xx0x/badger/pcb/badger_v2/jlcpcb/production_files/BOM-badger_v2.csv

Comment | Designator | Footprint | LCSC | Quantity
0 | R19,R20 | R_0603_1608Metric | C21189 | 2
10 (250mW) | R34,R35 | R_0805_2012Metric | C317221 | 2
100k | R22,R36,R49,R9 | R_0603_1608Metric | C25803 | 4
100n | C10,C2,C23,C3,C5,C6,C7,C8,C9 | C_0603_1608Metric | C14663 | 9
10k | R3,R32,R8 | R_0603_1608Metric | C25804 | 3
10p | C21,C22 | C_0603_1608Metric | C1634 | 2
10u | C1,C11,C24,C4 | C_0603_1608Metric | C19702 | 4
1206-PTSMD026 | Q1,Q2,Q3 | Phototransistor | C242255 | 3
150k | R46 | R_0603_1608Metric | C22807 | 1
1N4148W | D4 | D_SOD-123 | C81598 | 1
1k | R10,R14,R17,R18,R37,R40,R43 | R_0603_1608Metric | C21190 | 7
1u | C12,C13,C14,C15,C16,C17,C18,C19,C20 | C_0603_1608Metric | C15849 | 9
20k | R15,R23,R24,R25,R26,R27,R28,R31,R33 | R_0603_1608Metric | C4184 | 9
220 | R38,R4,R41,R44,R5 | R_0603_1608Metric | C22962 | 5
24C02S(XBLW) | U4 | SOT-23-5 | C18723540 | 1
2k2 | R29,R30 | R_0603_1608Metric | C4190 | 2
33 (250mW) | R6,R7 | R_0805_2012Metric | C17634 | 2
33k | R16 | R_0603_1608Metric | C4216 | 1
470 | R39,R42,R45 | R_0603_1608Metric | C23179 | 3
500 mA | F1 | Fuse_0805_2012Metric | C2977522 | 1
5V1 | D5 | D_SOD-123 | C19077401 | 1
5k1 | R1,R11,R12,R13,R2,R47,R48 | R_0603_1608Metric | C23186 | 7
74AHCT1G14 | U6 | SOT-23-5 | C55144666 | 1
AO3401A | Q5 | SOT-23 | C15127 | 1
B5819W | D6 | D_SOD-123 | C8598 | 1
GZ2012D601TF | FB1 | L_0805_2012Metric | C1017 | 1
LPA4722AQVF | U3 | WQFN-16-1EP_3x3mm_P0.5mm_EP1.6x1.6mm_ThermalVias | C517163 | 1
ME6211C33M5 | U5 | SOT-23-5 | C82942 | 1
MHP5050DRGBCT | D1,D2,D3 | LED_RGB_5050-6 | C7470880 | 3
MMBT3904 | Q4 | SOT-23 | C20526 | 1
MST-22D18G3-BD | SW4 | MST-22D18G3-BD | C7507441 | 1
PJ-313D | J2,J3,J4 | Jack_3.5mm_PJ-313D | C668608 | 3
PY32F071C1BU6TR | U7 | QFN-48-1EP_6x6mm_P0.4mm_EP4.3x4.3mm | C7434410 | 1
TLP185 | U2 | SOIC-4_4.55x3.7mm_P2.54mm | C388375 | 1
USBLC6-2SC6 | U1 | SOT-23-6 | C2687116 | 1
USB_C_Receptacle_USB2.0_16P | J1 | TYPE-C-31-M-12 | C2765186 | 1
X322524MOB4SI | Y1 | Crystal_SMD_3225-4Pin_3.2x2.5mm | C70590 | 1
