xx0x/badger/3d_models/badger-bottom-plate.step

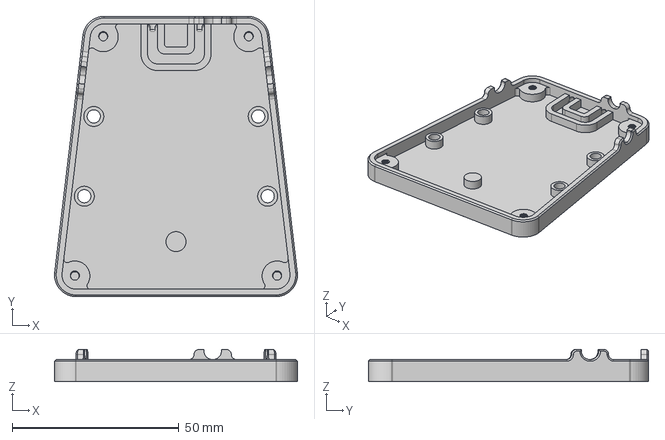
[picture p3: CAD file, 2026-10-28]
3d_models/badger-bottom-plate.step
72.8 x 84.0 x 9.60 mm
