xx0x/badger/pcb/badger_v2/3d_models/TLP185E.STEP

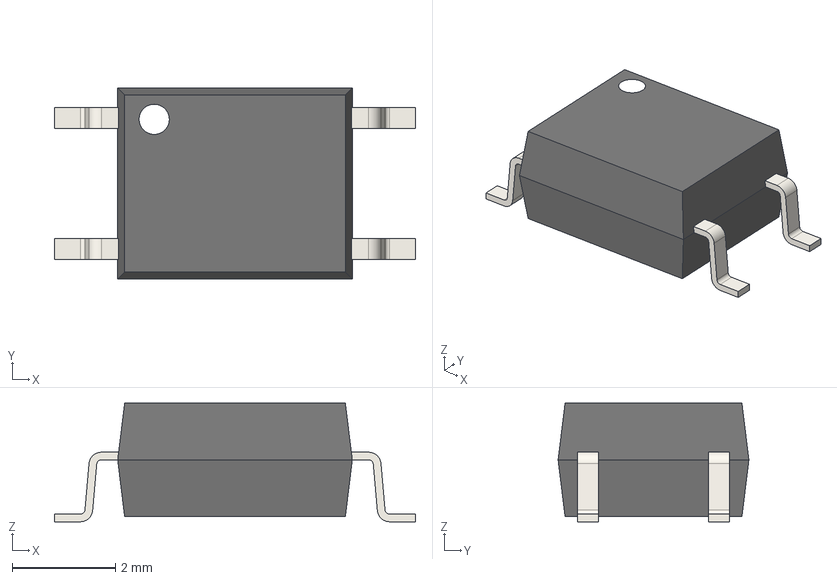
[picture p4: CAD file, 2026-10-28]
pcb/badger_v2/3d_models/TLP185E.STEP
7.00 x 3.70 x 2.30 mm
