xx0x/badger/pcb/badger_v2/3d_models/RV09ACF-40-20K-B10K.step

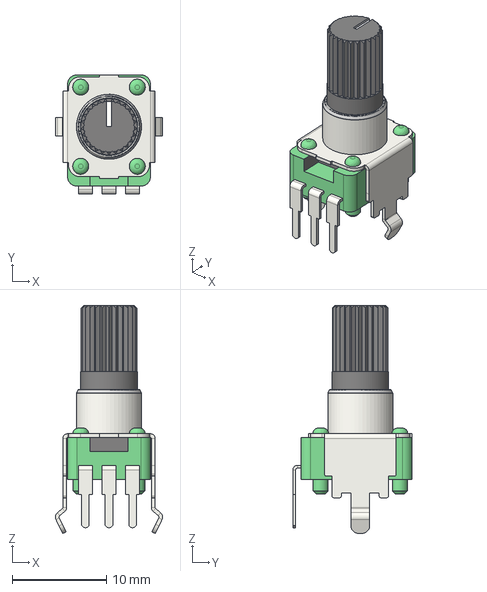
[picture p5: CAD file, 2026-10-28]
pcb/badger_v2/3d_models/RV09ACF-40-20K-B10K.step
11.4 x 12.7 x 24.2 mm
