xx0x/badger/pcb/badger_v2/3d_models/MST22D18G2.step

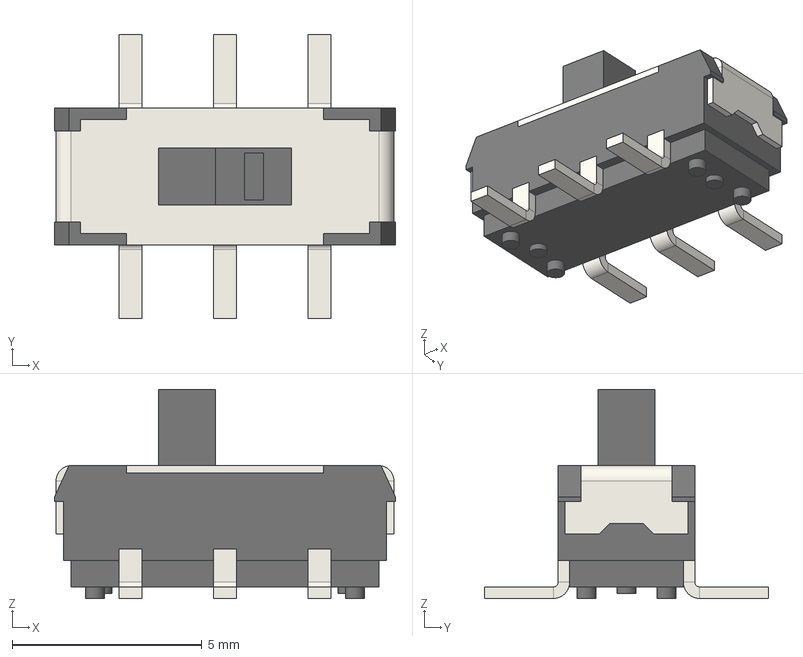
[picture p6: CAD file, 2026-10-28]
pcb/badger_v2/3d_models/MST22D18G2.step
8.99 x 7.49 x 5.51 mm
