xx0x/badger/pcb/badger_v2/3d_models/PJ313D.STEP

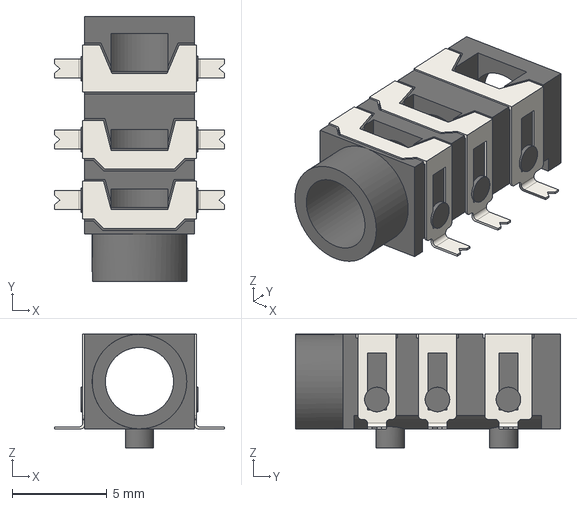
[picture p7: CAD file, 2026-10-28]
pcb/badger_v2/3d_models/PJ313D.STEP
9.00 x 14.0 x 6.00 mm
