xx0x/badger/pcb/badger_v2/3d_models/MHP5050DRGBCT.step

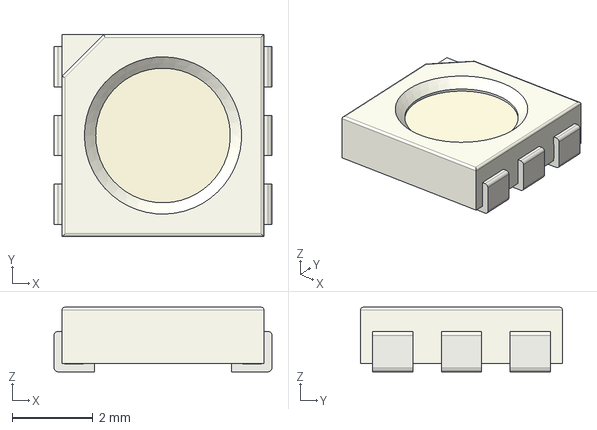
[picture p8: CAD file, 2026-10-28]
pcb/badger_v2/3d_models/MHP5050DRGBCT.step
5.40 x 5.00 x 1.60 mm
