xx0x/badger/pcb/badger_v2/3d_models/B3F_4000.step

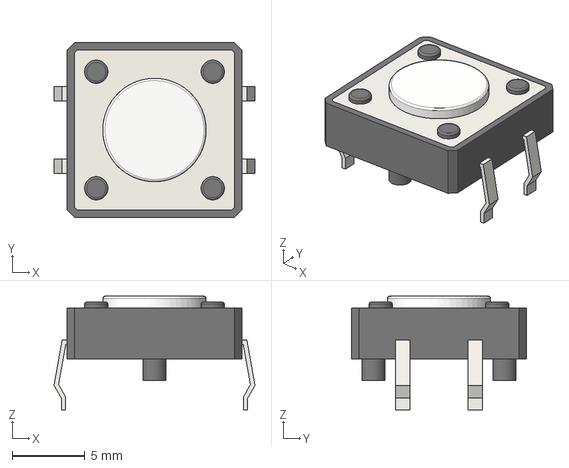
[picture p9: CAD file, 2026-10-28]
pcb/badger_v2/3d_models/B3F_4000.step
13.8 x 12.0 x 7.80 mm
