xx0x/badger/(list of files, cad)

Other CAD files:
3d_models/badger-bottom-plate.stl
3d_models/blender/badger.blend
