xx0x/badger/pcb/badger_v2/badger_v2.pdf

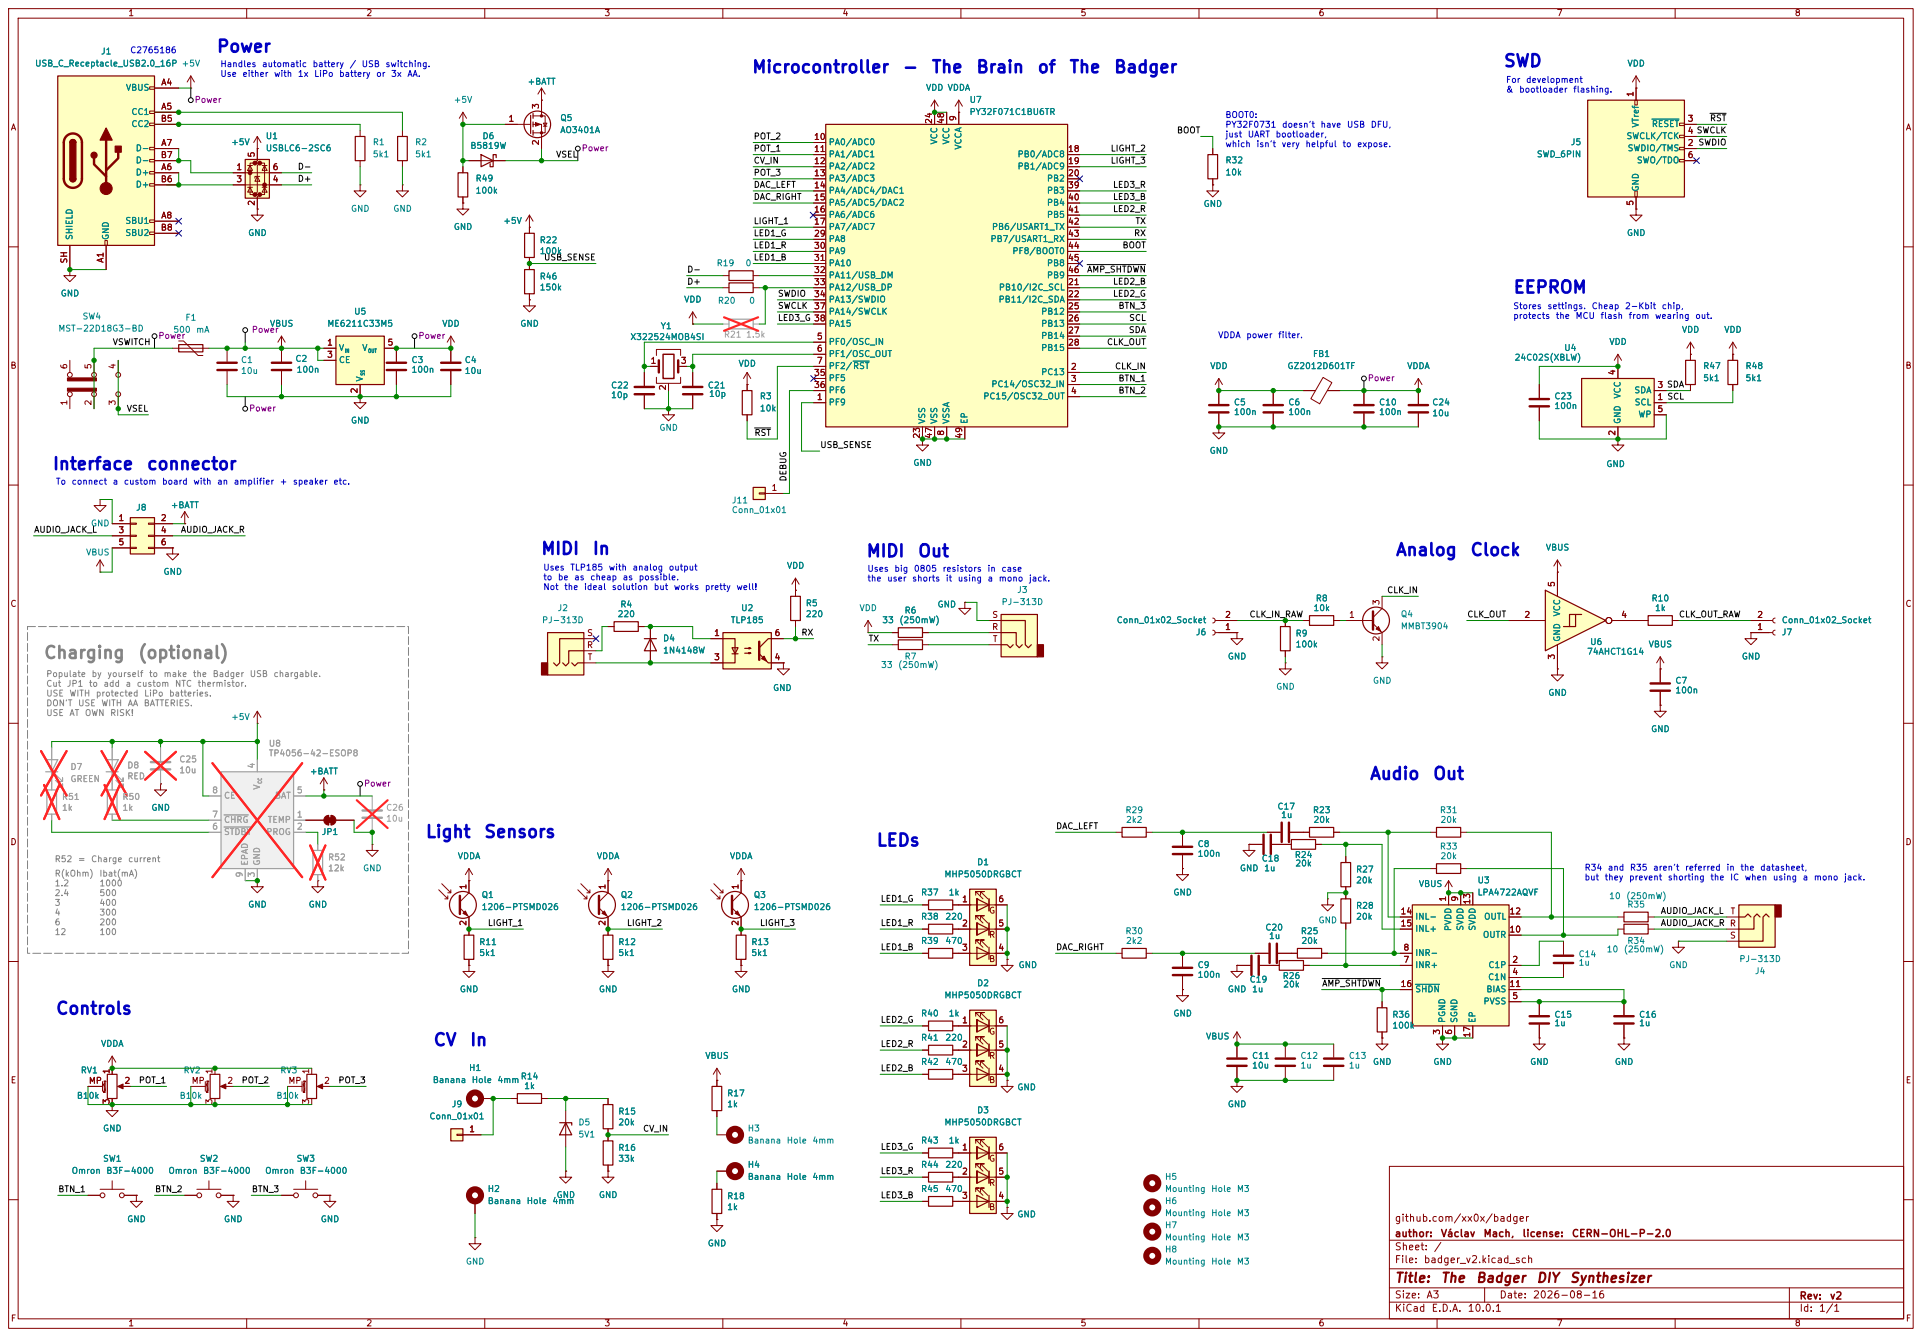
[picture p25: page 1]

R34 and R35 aren't referred in the datasheet, but they prevent shorting the IC when using a mono jack. Microcontroller - The Brain of The Badger

For development & bootloader flashing. BOOT0: PY32F0731 doesn't have USB DFU,

Stores settings. Cheap 2-Kbit chip, protects the MCU flash from wearing out. Uses TLP185 with analog output

to be as cheap as possible. Not the ideal solution but works pretty well!

Uses big 0805 resistors in case
the user shorts it using a mono jack. LEDs

9 OUTR 10 BIAS 11 OUTL 12 SVDD 13

github.com/xx0x/badger
author: Václav Mach, license: CERN-OHL-P-2.0
Id: 1/1 Title: The Badger DIY Synthesizer File: badger_v2.kicad_sch Sheet: /
