xx0x/badger/manuals/badger-quick-guide-en.pdf

# The Badger

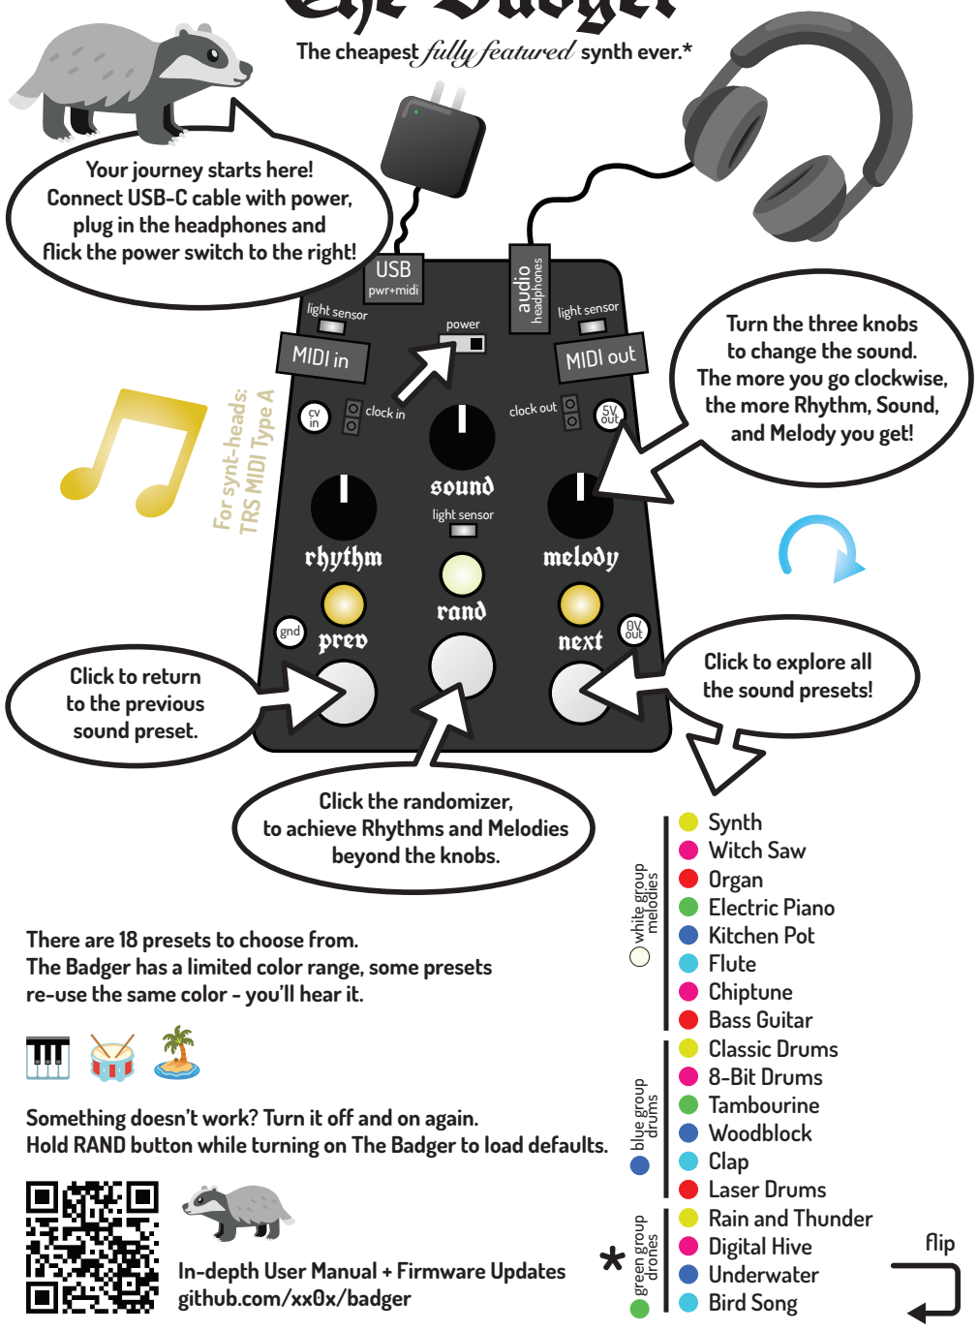
[picture p26: figure]
rhythm; sound; melody; rand; prev; next; MIDI in; MIDI out; audio; USB pwr+midi; headphones; clock in; clock out; gnd; 5Vout; power; 0Vout; light sensor; Turn the three knobs to change the sound. The more you go clockwise, the more Rhythm, Sound, and Melody you get!; Your journey starts here! Connect USB-C cable with power, plug in the headphones and flick the power switch to the right!; Click to explore all the sound presets!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

### white group melodies blue group drums green group drones

The Badger has a limited color range, some presets

The cheapest fully featured synth ever.*

Something doesn’t work? Turn it off and on again.
Hold RAND button while turning on The Badger to load defaults.

*With a grain of salt

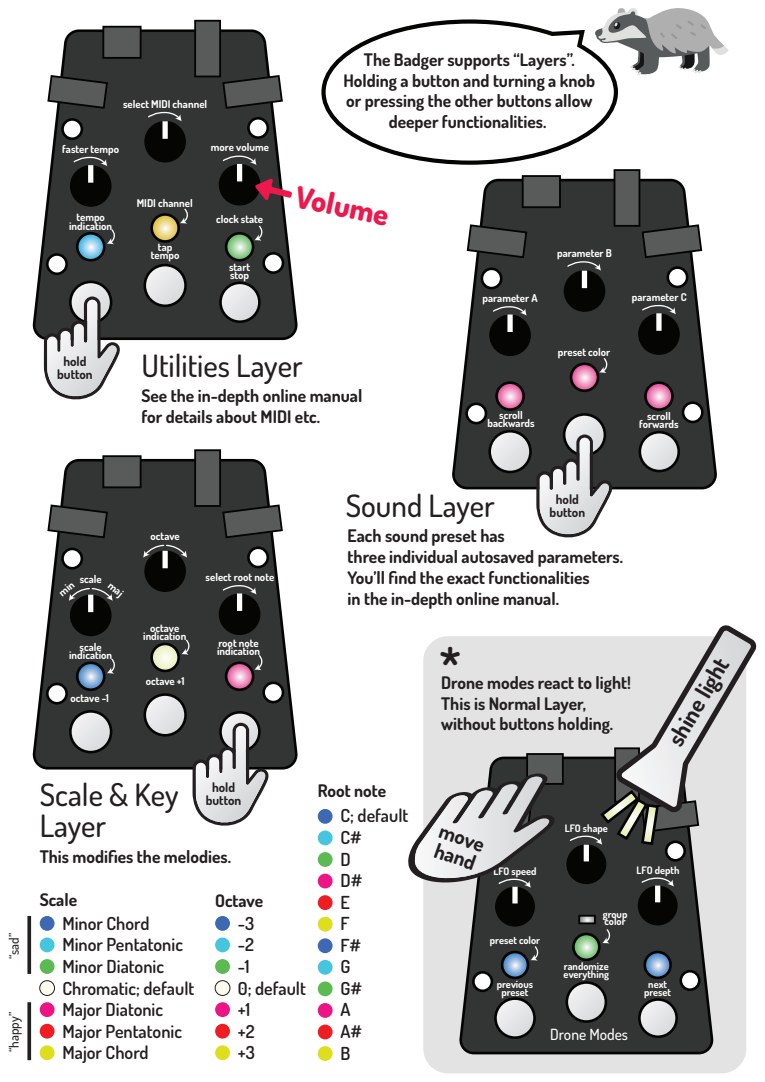
[picture p27: page 2]
MIDI channel; faster tempo; more volume; tempo indication; hold button; start stop; tap tempo; clock state; preset color; parameter A; parameter B; parameter C; scroll forwards; scroll backwards; octave indication; octave; scale indication; octave -1; octave +1; scale maj; min; -3 -2 -1 0; default +1 +2 +3; Octave; C; default C# D D# E F F# G G# A A# B; Root note; Minor Chord Minor Pentatonic Minor Diatonic Chromatic; default Major Diatonic Major Pentatonic Major Chord; Scale; “happy” “sad”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

The Badger supports “Layers”.
Holding a button and turning a knob
or pressing the other buttons allow
deeper functionalities.

select MIDI channel

Utilities Layer
See the in-depth online manual
for details about MIDI etc.

Sound Layer
Each sound preset has
three individual autosaved parameters.
You’ll find the exact functionalities
in the in-depth online manual.
Drone modes react to light!
This is Normal Layer,
without buttons holding.

select root note

root note indication

Scale & Key
Layer
This modifies the melodies.
