xx0x/badger/pcb/badger_v2/badger_v2.kicad_pcb

## KiCad design pcb/badger_v2/badger_v2.kicad_pcb (2026-10-28)

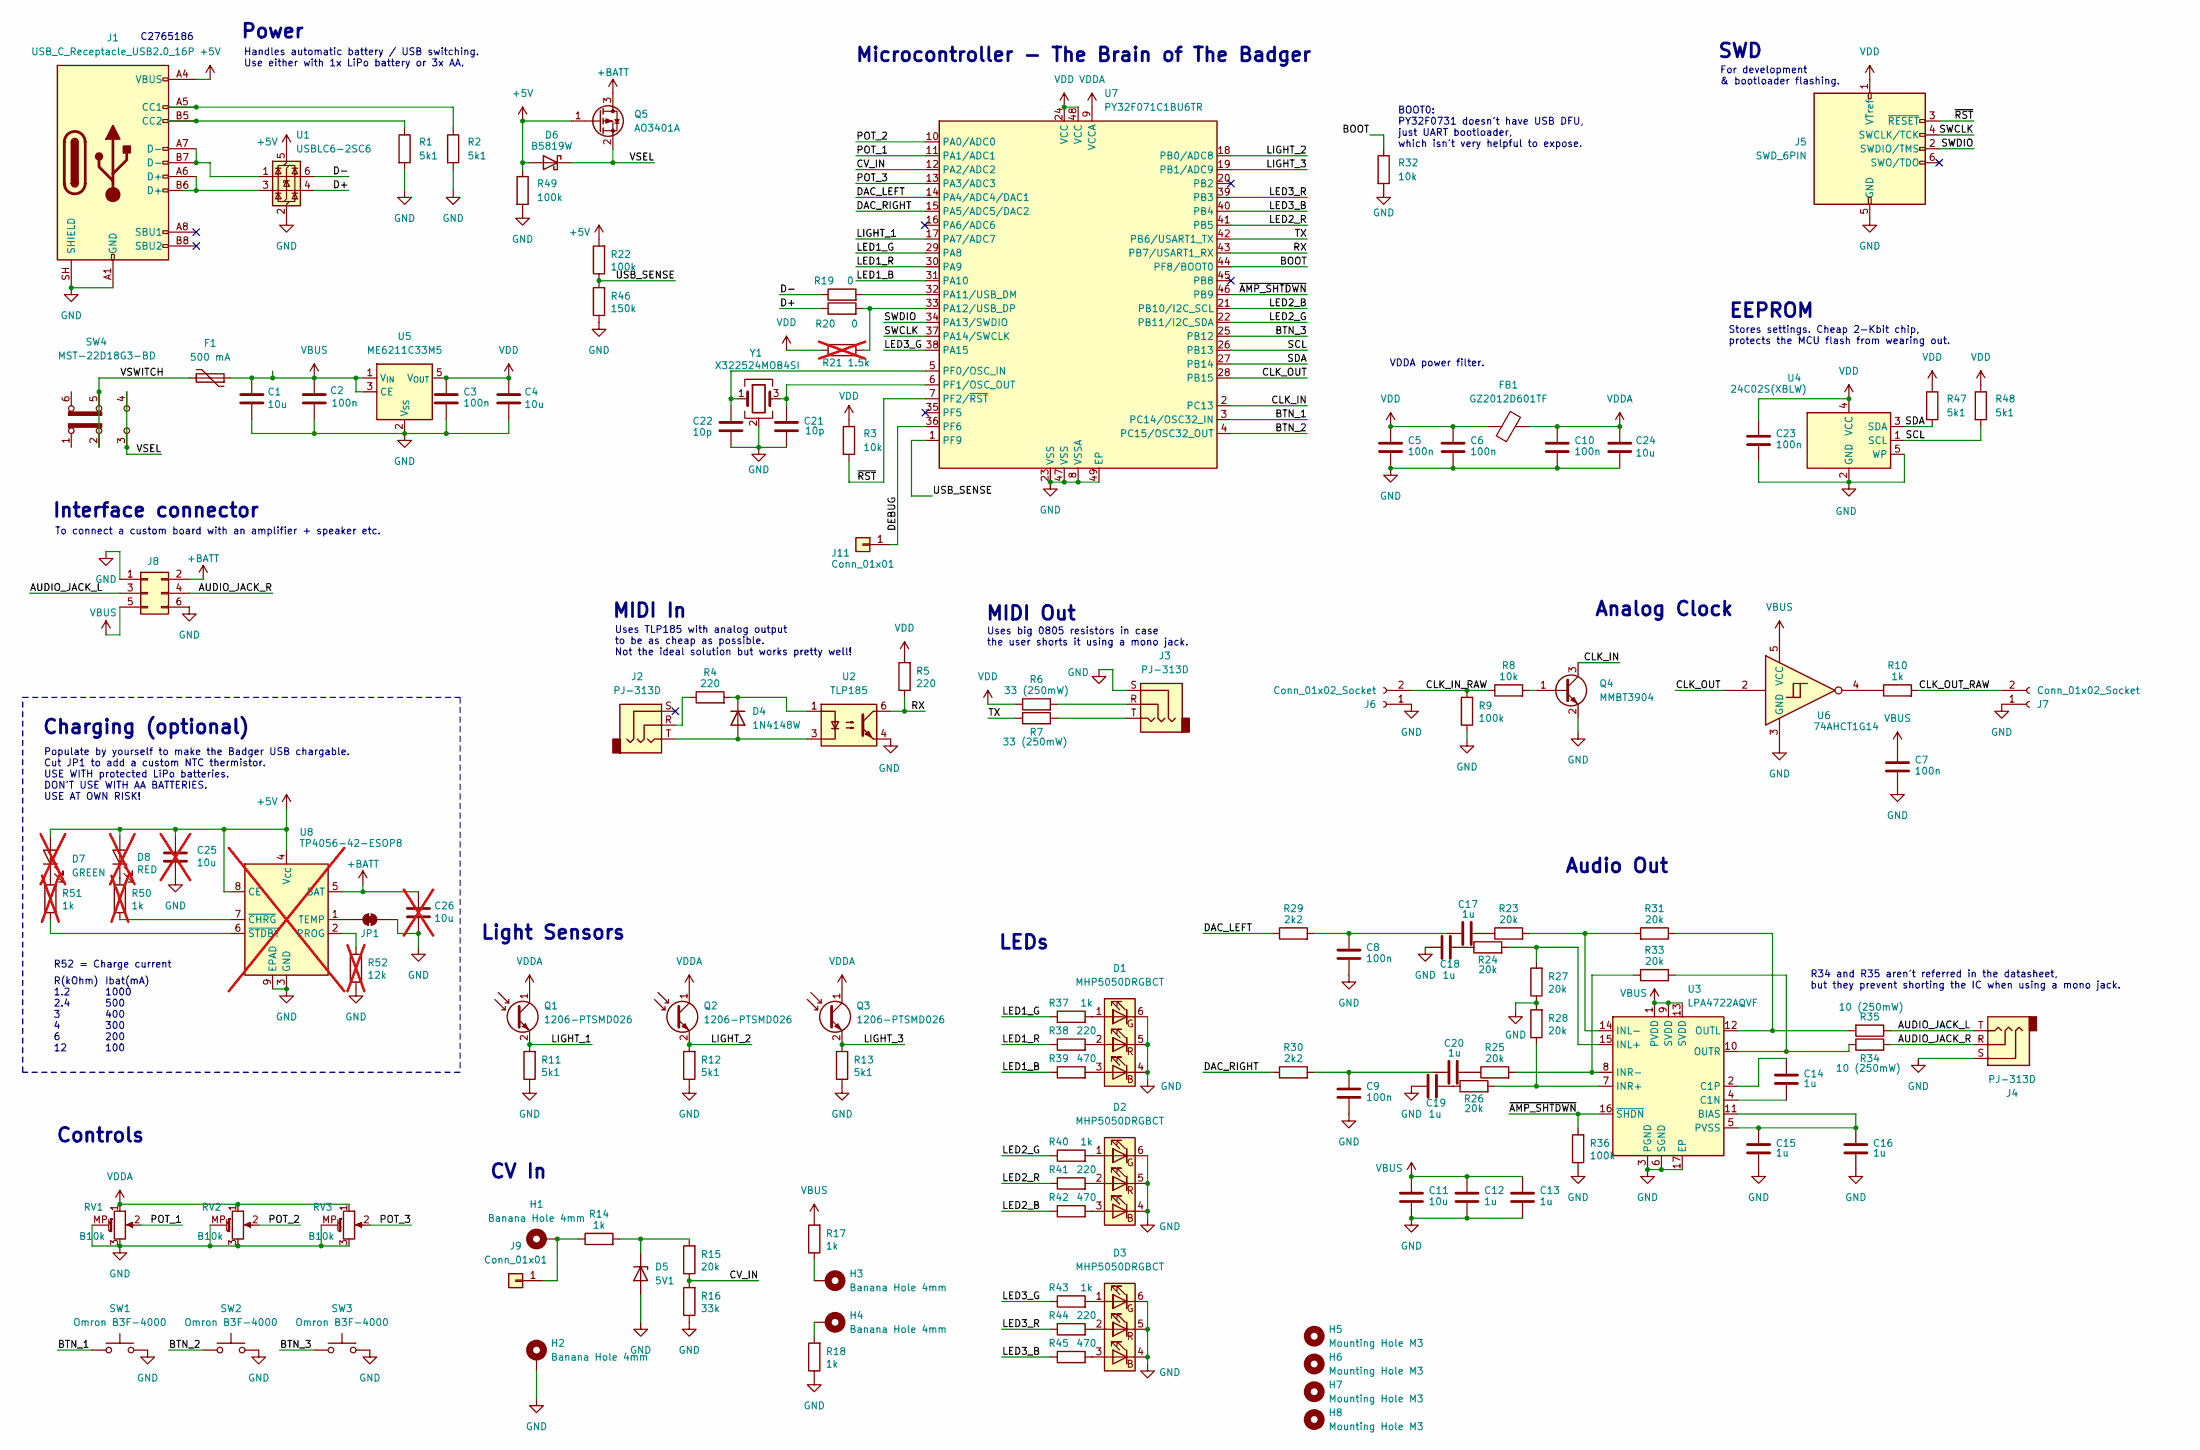
[picture p28: schematic badger_v2.kicad_sch, The Badger DIY Synthesizer]

Parts:
C1, C4, C11, C24: 10u; C_0603_1608Metric
C2, C3, C5, C6, C7, C8, C9, C10, C23: 100n; C_0603_1608Metric
C12, C13, C14, C15, C16, C17, C18, C19, C20: 1u; C_0603_1608Metric
C21, C22: 10p; C_0603_1608Metric
C25, C26: 10u; C_0603_1608Metric; not fitted
D1, D2, D3: MHP5050DRGBCT; LED_RGB_5050-6
D4: 1N4148W; D_SOD-123
D5: 5V1; D_SOD-123
D6: B5819W; D_SOD-123
D7: GREEN; LED_0805_2012Metric_Pad1.15x1.40mm_HandSolder; not fitted
D8: RED; LED_0805_2012Metric_Pad1.15x1.40mm_HandSolder; not fitted
F1: 500 mA; Fuse_0805_2012Metric
FB1: GZ2012D601TF; L_0805_2012Metric
H1, H2, H3, H4: Banana Hole 4mm; BananaHole_4mm
H5, H6, H7, H8: Mounting Hole M3; MountingHole_3.2mm_M3
J1: USB_C_Receptacle_USB2.0_16P; TYPE-C-31-M-12
J2, J3, J4: PJ-313D; Jack_3.5mm_PJ-313D
J5: SWD_6PIN; PinHeader_2x03_P2.54mm_Vertical
J6, J7: Conn_01x02_Socket; PinSocket_1x02_P2.54mm_Vertical
J8: Conn_02x03_Odd_Even; IDC-Header_2x03_P2.54mm_Vertical
J9, J11: Conn_01x01; PinHeader_1x01_P2.54mm_Vertical_Round_NoSilk
JP1: SolderJumper_2_Bridged; SolderJumper-2_P1.3mm_Bridged_RoundedPad1.0x1.5mm
Q1, Q2, Q3: 1206-PTSMD026; Phototransistor
Q4: MMBT3904; SOT-23
Q5: AO3401A; SOT-23
R1, R2, R11, R12, R13, R47, R48: 5k1; R_0603_1608Metric
R3, R8, R32: 10k; R_0603_1608Metric
R4, R5, R38, R41, R44: 220; R_0603_1608Metric
R6, R7: 33 (250mW); R_0805_2012Metric
R9, R22, R36, R49: 100k; R_0603_1608Metric
R10, R14, R17, R18, R37, R40, R43: 1k; R_0603_1608Metric
R15, R23, R24, R25, R26, R27, R28, R31, R33: 20k; R_0603_1608Metric
R16: 33k; R_0603_1608Metric
R19, R20: 0; R_0603_1608Metric
R21: 1.5k; R_0603_1608Metric; not fitted
R29, R30: 2k2; R_0603_1608Metric
R34, R35: 10 (250mW); R_0805_2012Metric
R39, R42, R45: 470; R_0603_1608Metric
R46: 150k; R_0603_1608Metric
R50, R51: 1k; R_0603_1608Metric; not fitted
R52: 12k; R_0603_1608Metric; not fitted
RV1, RV2, RV3: B10k; PotAlpha_Plastic
SW1, SW2, SW3: Omron B3F-4000; SW_SPST_Omron_B3F-40xx_CENTER
SW4: MST-22D18G3-BD
U1: USBLC6-2SC6; SOT-23-6
U2: TLP185; SOIC-4_4.55x3.7mm_P2.54mm
U3: LPA4722AQVF; WQFN-16-1EP_3x3mm_P0.5mm_EP1.6x1.6mm_ThermalVias
U4: 24C02S(XBLW); SOT-23-5
U5: ME6211C33M5; SOT-23-5
U6: 74AHCT1G14; SOT-23-5
U7: PY32F071C1BU6TR; QFN-48-1EP_6x6mm_P0.4mm_EP4.3x4.3mm
U8: TP4056-42-ESOP8; SOIC-8-1EP_3.9x4.9mm_P1.27mm_EP2.41x3.3mm_ThermalVias; not fitted
Y1: X322524MOB4SI; Crystal_SMD_3225-4Pin_3.2x2.5mm

Connections:
+5V: C25.1, D6.2 (A), D7.2 (A), D8.2 (A), J1.A4 (VBUS), J1.A9 (VBUS), J1.B4 (VBUS), J1.B9 (VBUS), Q5.1 (G), R22.2, R49.1, U1.5 (VBUS), U8.4 (V_{CC}), U8.8 (CE)
+BATT: C26.1, J8.2, Q5.3 (D), U8.5 (BAT)
/AUDIO_JACK_L: J4.T, J8.3, R35.1
/AUDIO_JACK_R: J4.R, J8.4, R34.2
/BOOT: R32.1, U7.44 (PF8/BOOT0)
/BTN_1: SW1.1, U7.3 (PC14/OSC32_IN)
/BTN_2: SW2.1, U7.4 (PC15/OSC32_OUT)
/BTN_3: SW3.1, U7.25 (PB12)
/CLK_IN: Q4.3 (C), U7.2 (PC13)
/CLK_IN_RAW: J6.2, R8.1, R9.2
/CLK_OUT: U6.2, U7.28 (PB15)
/CLK_OUT_RAW: J7.2, R10.2
/CV_IN: R15.1, R16.2, U7.12 (PA2/ADC2)
/D+: R20.1, U1.4 (I/O2)
/D-: R19.1, U1.6 (I/O1)
/DAC_LEFT: R29.1, U7.14 (PA4/ADC4/DAC1)
/DAC_RIGHT: R30.1, U7.15 (PA5/ADC5/DAC2)
/DEBUG: J11.1 (Pin_1_1), U7.36 (PF6)
/LED1_B: R39.1, U7.31 (PA10)
/LED1_G: R37.1, U7.29 (PA8)
/LED1_R: R38.1, U7.30 (PA9)
/LED2_B: R42.1, U7.21 (PB10/I2C_SCL)
/LED2_G: R40.1, U7.22 (PB11/I2C_SDA)
/LED2_R: R41.1, U7.41 (PB5)
/LED3_B: R45.1, U7.40 (PB4)
/LED3_G: R43.1, U7.38 (PA15)
/LED3_R: R44.1, U7.39 (PB3)
/LIGHT_1: Q1.2 (E), R11.2, U7.17 (PA7/ADC7)
/LIGHT_2: Q2.2 (E), R12.2, U7.18 (PB0/ADC8)
/LIGHT_3: Q3.2 (E), R13.2, U7.19 (PB1/ADC9)
/POT_1: RV1.2, U7.11 (PA1/ADC1)
/POT_2: RV2.2, U7.10 (PA0/ADC0)
/POT_3: RV3.2, U7.13 (PA3/ADC3)
/RX: R5.1, U2.6, U7.43 (PB7/USART1_RX)
/SCL: R48.2, U4.1 (SCL), U7.26 (PB13)
/SDA: R47.2, U4.3 (SDA), U7.27 (PB14)
/SWCLK: J5.4 (SWCLK/TCK), U7.37 (PA14/SWCLK)
/SWDIO: J5.2 (SWDIO/TMS), U7.34 (PA13/SWDIO)
/TX: R7.1, U7.42 (PB6/USART1_TX)
/USB_SENSE: R22.1, R46.2, U7.1 (PF9)
/VSEL: D6.1 (K), Q5.2 (S), SW4.3 (C), SW4.4 (A)
/VSWITCH: F1.2, SW4.2 (B), SW4.5 (B)
/~AMP_SHTDWN: R36.2, U3.16 (~SHDN), U7.46 (PB9)
/~RST: J5.3 (~RESET), R3.2, U7.7 (PF2/~RST)
GND: C1.2, C2.2, C3.2, C4.2, C5.2, C6.2, C7.2, C8.2, C9.2, C10.2, C11.2, C12.2, C13.2, C15.2, C16.2, C18.1, C19.1, C21.1, C22.1, C23.2, C24.2, C25.2, C26.2, D1.4 (BK), D1.5 (RK), D1.6 (GK), D2.4 (BK), D2.5 (RK), D2.6 (GK), D3.4 (BK), D3.5 (RK), D3.6 (GK), D5.2 (A), H2.1 (1_1), J1.A1 (GND), J1.A12 (GND), J1.B1 (GND), J1.B12 (GND), J1.SH (SHIELD), J3.S, J4.S, J5.5 (GND), J6.1, J7.1, J8.1, J8.6, JP1.2 (B), Q4.2 (E), R1.2, R2.2, R9.1, R11.1, R12.1, R13.1, R16.1, R18.1, R27.1, R28.2, R32.2, R36.1, R46.1, R49.2, R52.1, RV1.3, RV1.MP (MountPin), RV2.3, RV2.MP (MountPin), RV3.3, RV3.MP (MountPin), SW1.2, SW2.2, SW3.2, U1.2 (GND), U2.4, U3.3 (PGND), U3.6 (SGND), U3.17 (EP), U4.2 (GND), U4.5 (WP), U5.2 (V_{SS}), U6.3 (GND), U7.8 (VSSA), U7.23 (VSS), U7.47 (VSS), U7.49 (EP), U8.3 (GND), U8.9 (EPAD), Y1.2 (G), Y1.4 (G)
unnamed: C8.1, C17.1, R29.2
unnamed: C17.2, R23.1
unnamed: C18.2, R24.1
unnamed: C19.2, R26.1
unnamed: C9.1, C20.1, R30.2
unnamed: C20.2, R25.1
unnamed: D1.3 (BA), R39.2
unnamed: D1.1 (GA), R37.2
unnamed: D1.2 (RA), R38.2
unnamed: D2.3 (BA), R42.2
unnamed: D2.1 (GA), R40.2
unnamed: D2.2 (RA), R41.2
unnamed: D3.3 (BA), R45.2
unnamed: D3.1 (GA), R43.2
unnamed: D3.2 (RA), R44.2
unnamed: D4.2 (A), J2.T, U2.3
unnamed: D4.1 (K), R4.2, U2.1
unnamed: D5.1 (K), R14.2, R15.2
unnamed: D7.1 (K), R51.2
unnamed: D8.1 (K), R50.2
unnamed: H3.1 (1_1), R17.1
unnamed: H4.1 (1_1), R18.2
unnamed: J1.A5 (CC1), R2.1
unnamed: J1.B5 (CC2), R1.1
unnamed: J1.A6 (D+), J1.B6 (D+), U1.3 (I/O2)
unnamed: J1.A7 (D-), J1.B7 (D-), U1.1 (I/O1)
unnamed: J2.R, R4.1
unnamed: J3.R, R6.2
unnamed: J3.T, R7.2
unnamed: H1.1 (1_1), J9.1 (Pin_1_1), R14.1
unnamed: JP1.1 (A), U8.1 (TEMP)
unnamed: Q4.1 (B), R8.2
unnamed: R10.1, U6.4
unnamed: C15.1, C16.1, U3.5 (PVSS), U3.11 (BIAS)
unnamed: C14.2, U3.4 (C1N)
unnamed: C14.1, U3.2 (C1P)
unnamed: R24.2, R27.2, U3.15 (INL+)
unnamed: R23.2, R31.2, U3.14 (INL-)
unnamed: R26.2, R28.1, U3.7 (INR+)
unnamed: R25.2, R33.1, U3.8 (INR-)
unnamed: R31.1, R35.2, U3.12 (OUTL)
unnamed: R33.2, R34.1, U3.10 (OUTR)
unnamed: R19.2, U7.32 (PA11/USB_DM)
unnamed: R20.2, R21.1, U7.33 (PA12/USB_DP)
unnamed: C22.2, U7.5 (PF0/OSC_IN), Y1.1
unnamed: C21.2, U7.6 (PF1/OSC_OUT), Y1.3
unnamed: R52.2, U8.2 (PROG)
unnamed: R50.1, U8.7 (~CHRG)
unnamed: R51.1, U8.6 (~STDBY)
VBUS: C1.1, C2.1, C7.1, C11.1, C12.1, C13.1, F1.1, J8.5, R17.2, U3.1 (PVDD), U3.9 (SVDD), U3.13 (SVDD), U5.1 (V_{IN}), U5.3 (CE), U6.5 (VCC)
VDD: C3.1, C4.1, C5.1, C6.1, C23.1, FB1.1, J5.1 (VTref), R3.1, R5.2, R6.1, R21.2, R47.1, R48.1, U4.4 (VCC), U5.5 (V_{OUT}), U7.24 (VCC), U7.48 (VCC)
VDDA: C10.1, C24.1, FB1.2, Q1.1 (C), Q2.1 (C), Q3.1 (C), RV1.1, RV2.1, RV3.1, U7.9 (VCCA)

Notes on the sheet:
Audio Out
Uses TLP185 with analog output to be as cheap as possible. Not the ideal solution but works pretty well!
Uses big 0805 resistors in case the user shorts it using a mono jack.
C2765186
EEPROM
Controls
Stores settings. Cheap 2-Kbit chip, protects the MCU flash from wearing out.
R34 and R35 aren't referred in the datasheet, but they prevent shorting the IC when using a mono jack.
Handles automatic battery / USB switching. Use either with 1x LiPo battery or 3x AA.
VDDA power filter.
Microcontroller - The Brain of The Badger
Analog Clock
To connect a custom board with an amplifier + speaker etc.
SWD
BOOT0: PY32F0731 doesn't have USB DFU, just UART bootloader, which isn't very helpful to expose.
MIDI Out
Charging (optional)
R52 = Charge current
CV In
Interface connector
Populate by yourself to make the Badger USB chargable. Cut JP1 to add a custom NTC thermistor. USE WITH protected LiPo batteries. DON'T USE WITH AA BATTERIES. USE AT OWN RISK!
For development & bootloader flashing.
Ibat(mA) 1000 500 400 300 200 100
Light Sensors
MIDI In
R(kOhm) 1.2 2.4 3 4 6 12
LEDs
Power

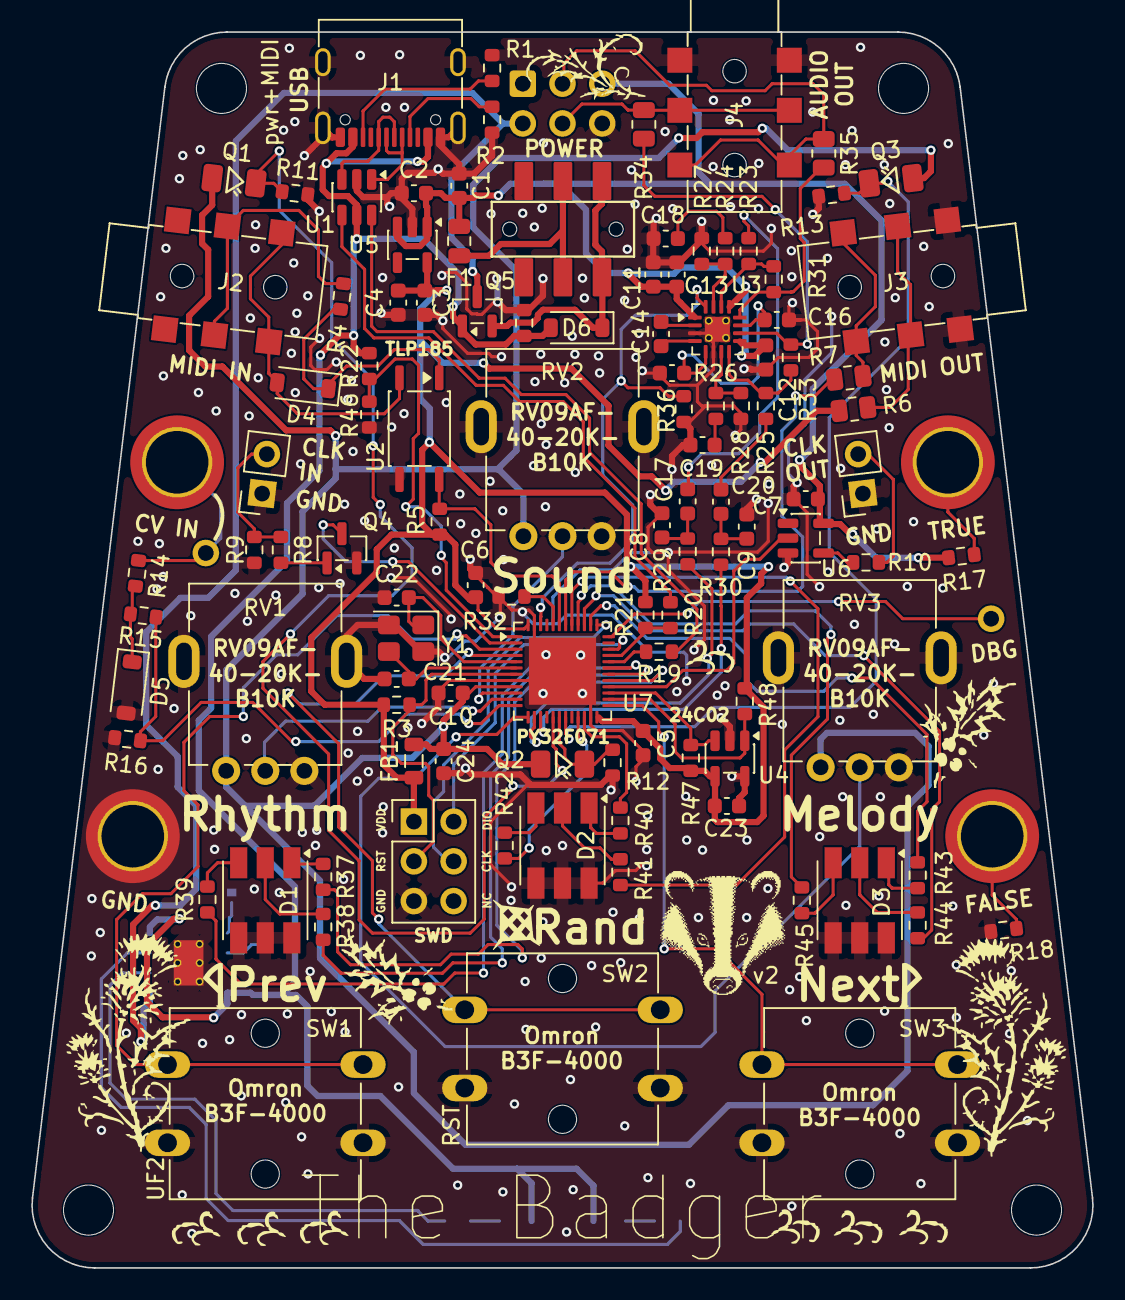
[picture p29: board badger_v2.kicad_pcb from above]

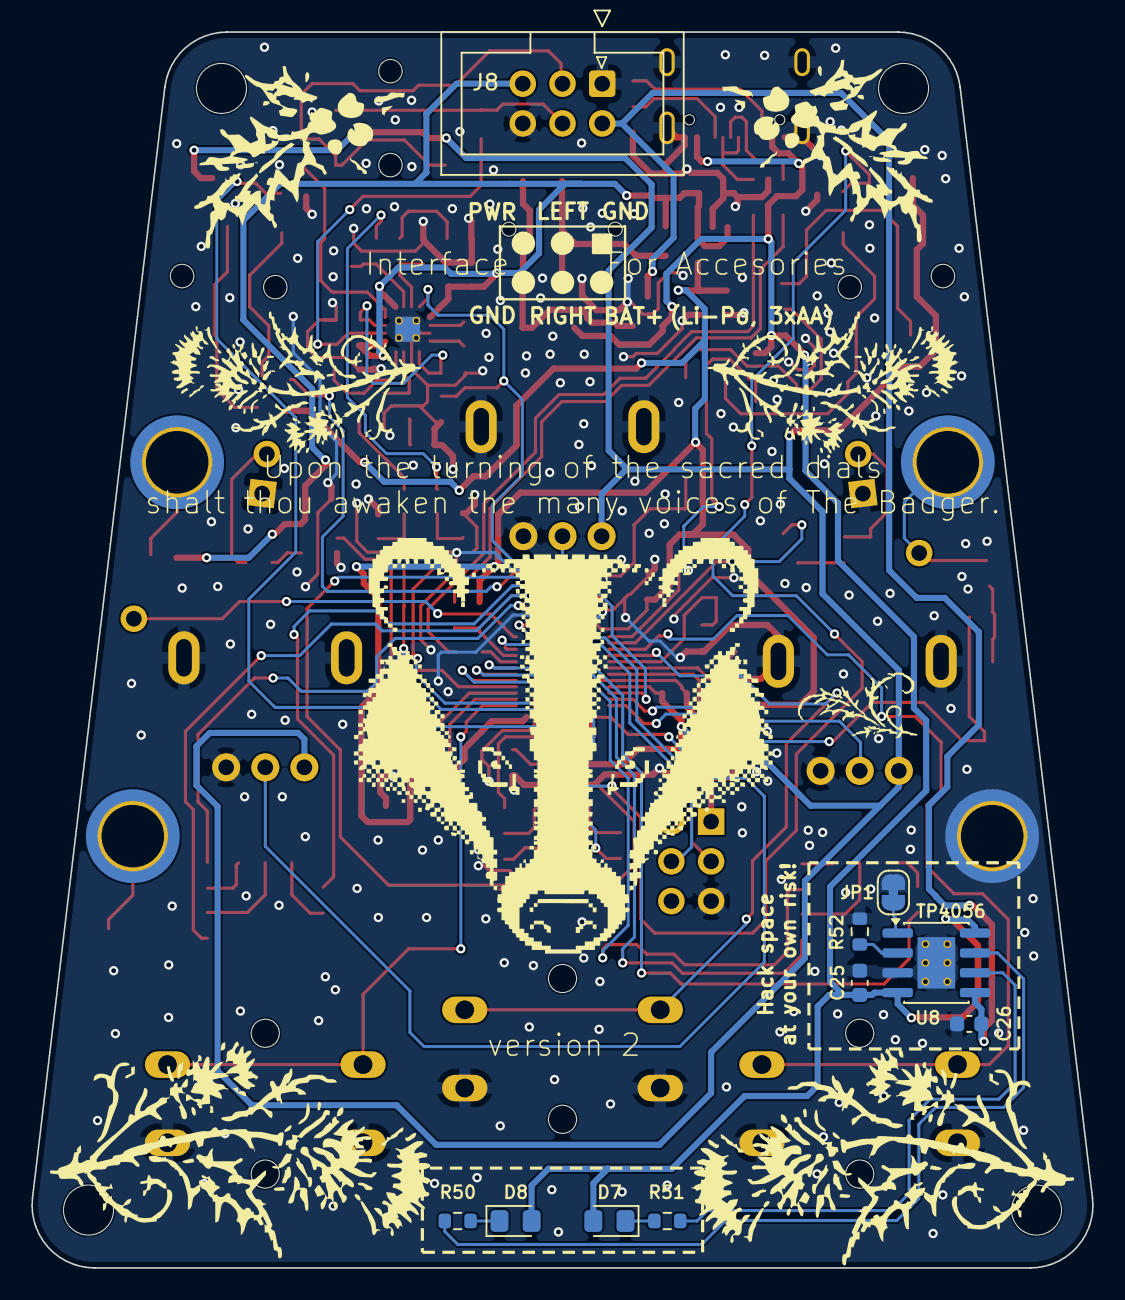
[picture p30: board badger_v2.kicad_pcb from below]

Board: 2 copper layers, 67.8 x 79.0 mm, 128 parts (10 on the bottom side), 97 nets.
