xx0x/badger/code/src/main.cpp

/*
MIT License

Copyright (c) 2026 Vaclav Mach

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
THE SOFTWARE IS PROVIDED "AS IS", WITHOUT WARRANTY OF ANY KIND, EXPRESS OR
IMPLIED, INCLUDING BUT NOT LIMITED TO THE WARRANTIES OF MERCHANTABILITY,
FITNESS FOR A PARTICULAR PURPOSE AND NONINFRINGEMENT. IN NO EVENT SHALL THE
AUTHORS OR COPYRIGHT HOLDERS BE LIABLE FOR ANY CLAIM, DAMAGES OR OTHER
LIABILITY, WHETHER IN AN ACTION OF CONTRACT, TORT OR OTHERWISE, ARISING FROM,
OUT OF OR IN CONNECTION WITH THE SOFTWARE OR THE USE OR OTHER DEALINGS IN THE
SOFTWARE.
*/

#include "Badger.hpp"

using namespace badger;

/**
 * @file main.cpp
 * @brief Entry point for the Badger firmware. Nothing to see here much, just calls Badger::Init() and enters the main loop.
 * @author Vaclav Mach
 * @date 2026-06-04
 */
int main(void)
{
    Badger::Init();
    Badger::StartAudio();
    while (1)
    {
        Badger::UiLoop();
    }
}
