xx0x/badger/code/src/py32f071_hal_msp.c

/**
 ******************************************************************************
 * @file    py32f071_hal_msp.c
 * @author  MCU Application Team
 * @brief   This file provides code for the MSP Initialization
 *          and de-Initialization codes.
 ******************************************************************************
 * @attention
 *
 * <h2><center>&copy; Copyright (c) Puya Semiconductor Co.
 * All rights reserved.</center></h2>
 *
 * <h2><center>&copy; Copyright (c) 2016 STMicroelectronics.
 * All rights reserved.</center></h2>
 *
 * This software component is licensed by ST under BSD 3-Clause license,
 * the "License"; You may not use this file except in compliance with the
 * License. You may obtain a copy of the License at:
 *                        opensource.org/licenses/BSD-3-Clause
 *
 ******************************************************************************
 */

/* Includes ------------------------------------------------------------------*/
#include "py32f0xx_hal.h"

/* Private typedef -----------------------------------------------------------*/
/* Private define ------------------------------------------------------------*/
/* Private macro -------------------------------------------------------------*/
/* Private variables ---------------------------------------------------------*/
/* Private function prototypes -----------------------------------------------*/
/* External functions --------------------------------------------------------*/

/**
 * @brief  Configure the Flash prefetch and the Instruction cache,
 *         the time base source, NVIC and any required global low level hardware
 *         by calling the HAL_MspInit() callback function from HAL_Init()
 *
 */
void HAL_MspInit(void)
{
}

/************************ (C) COPYRIGHT Puya *****END OF FILE******************/
